dustpot/indoor-air-monitor/docs/images/asthma-index-bedroom.jpg

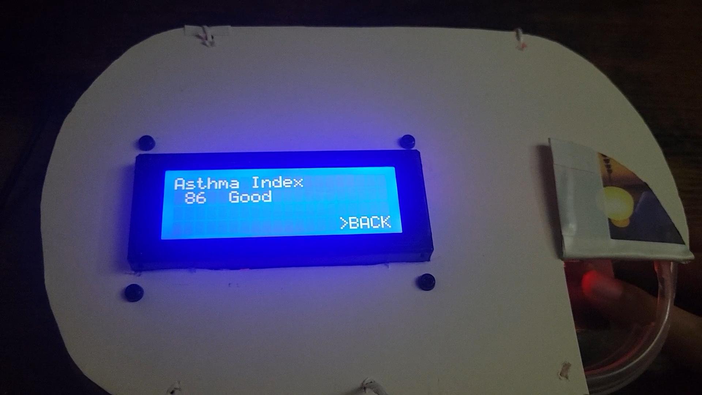
docs/images/asthma-index-bedroom.jpg
