dustpot/indoor-air-monitor/docs/images/asthma-index-kitchen.jpg

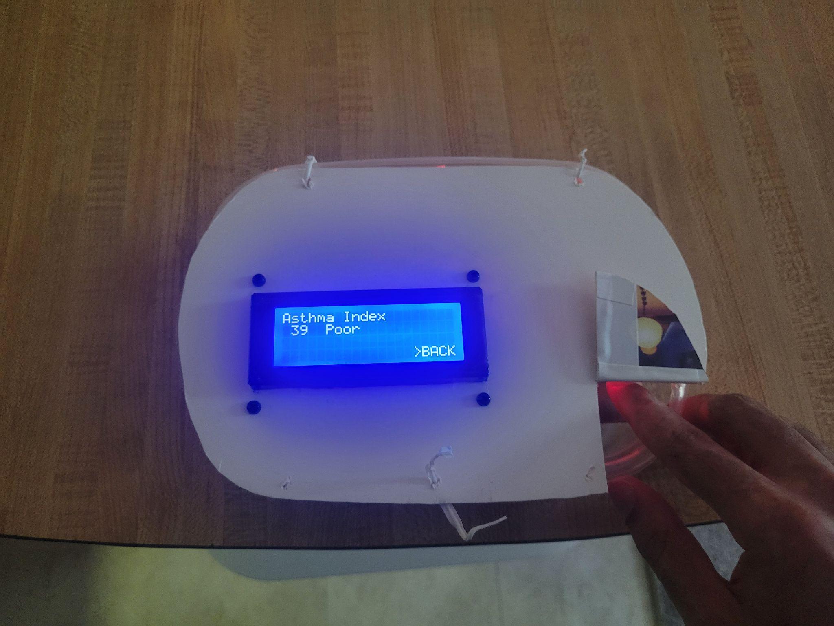
docs/images/asthma-index-kitchen.jpg
