dustpot/indoor-air-monitor/docs/images/breadboard-prototype.jpg

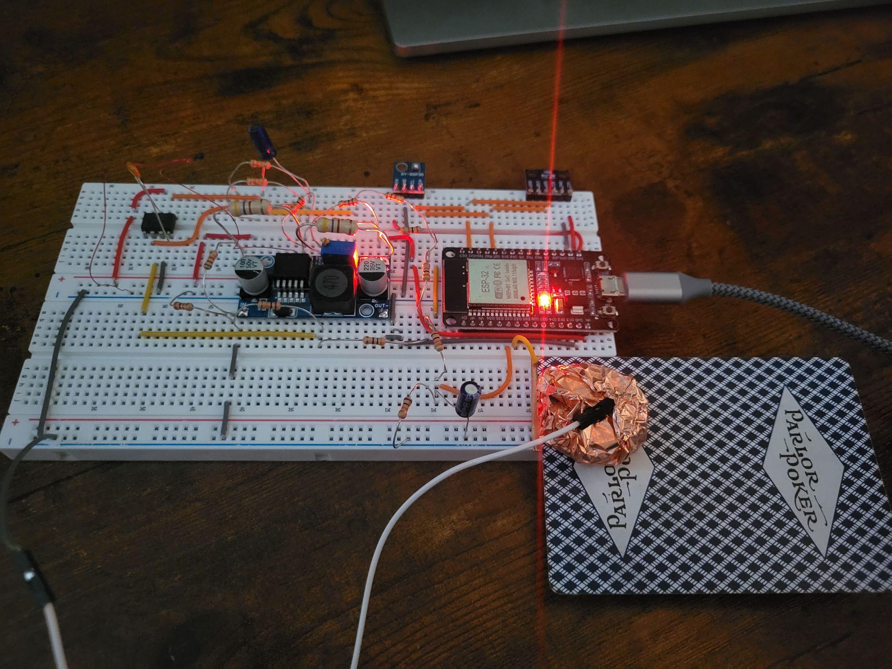
docs/images/breadboard-prototype.jpg
