dustpot/indoor-air-monitor/docs/BOM.md

# Bill of materials

From Appendix C of the final report ([report.pdf](report.pdf)).

| Part | Qty | Cost | Link | Notes |
| --- | --- | --- | --- | --- |
| ESP32 dev board (CP2102) | 1 | $9.39 | [link](https://www.amazon.com/dp/B07WCG1PLV) | μC, WiFi, touch peripheral, ADC |
| BME280 breakout | 1 | $8.99 | [link](https://www.amazon.com/dp/B01N47LZ4P) | Temp/%RH/Pressure, pre-packaged #1 |
| SGP30 breakout | 1 | $12.49 | [link](https://www.amazon.com/dp/B0CDWXNZR9) | eCO₂/TVOC, pre-packaged #2 |
| 10 kΩ NTC thermistor (10-pk) | 1 | $7.99 | [link](https://www.amazon.com/dp/B0F3X2G4D2) | RAW sensor; β fitted 3992 K |
| TL071CP op-amp | 1 | $0.51 | [link](https://www.digikey.com/en/products/detail/texas-instruments/TL071CP/378372) | Thermistor front-end gain stage |
| Resistors R₁–R₈ | 8 | $0.80 | [link](https://www.digikey.com/en/products/filter/through-hole-resistors/53) | Front-end network |
| Capacitors C₁–C₃ | 3 | $0.30 | [link](https://www.digikey.com/en/products/filter/aluminum-electrolytic-capacitors/58) | Filters and decoupling |
| LM2596 buck module (2-pk) | 1 | $4.99 | [link](https://www.amazon.com/dp/B0D7ZWVSFW) | Battery's ~8.4 V to a regulated 5.0 V |
| 6×AA NiMH + charger | 1 | $15.29 | [link](https://www.amazon.com/dp/B0GJCSSBFN) | ~20 Wh; more energy than 9 V alternative |
| Copper tape | 1 | $7.99 | [link](https://www.amazon.com/dp/B09Z6F9RFG) | Homemade capacitive sensor |
| 20×4 LCD w/ I²C backpack (2-pk) | 1 | $8.99 | [link](https://www.amazon.com/HiLetgo-Display-Backlight-Controller-Character/dp/B00HJ6AFW6) | Menu UI; 2pk is same price as single |
| Battery holder (6×AA) | 1 | $6.59 | [link](https://www.amazon.com/dp/B01N2INSBR) | 6 AA 9 V case with leads |
| Tupperware enclosure (3-pk) | 1 | $3.49 | [link](https://www.kroger.com/p/rubbermaid-takealongs-rectangle-food-storage-container-4-cup-tint-chili-3-count/0007169123100) | Link is close but not exact: 3pk from Kroger |

**Total ≈ $87.81**
