dustpot/indoor-air-monitor/data/Pressure Calibration (field 3).xlsx

created_at | entry_id | field3 | Average
2026-06-21 00:05:24 UTC | 1 | 987.54083 | 987.49112
2026-06-21 00:05:44 UTC | 2 | 987.52454
2026-06-21 00:06:05 UTC | 3 | 987.53131
2026-06-21 00:06:25 UTC | 4 | 987.51733
2026-06-21 00:06:46 UTC | 5 | 987.52032
2026-06-21 00:07:06 UTC | 6 | 987.52533
2026-06-21 00:07:27 UTC | 7 | 987.49237
2026-06-21 00:07:47 UTC | 8 | 987.50873
2026-06-21 00:08:08 UTC | 9 | 987.48883
2026-06-21 00:08:28 UTC | 10 | 987.47455
2026-06-21 00:08:49 UTC | 11 | 987.50415
2026-06-21 00:09:10 UTC | 12 | 987.46814
2026-06-21 00:09:30 UTC | 13 | 987.49292
2026-06-21 00:09:51 UTC | 14 | 987.47925
2026-06-21 00:10:11 UTC | 15 | 987.45709
2026-06-21 00:10:32 UTC | 16 | 987.47729
2026-06-21 00:10:52 UTC | 17 | 987.50281
2026-06-21 00:11:13 UTC | 18 | 987.47925
2026-06-21 00:11:33 UTC | 19 | 987.55627
2026-06-21 00:11:53 UTC | 20 | 987.52734
2026-06-21 00:12:14 UTC | 21 | 987.55737
2026-06-21 00:12:35 UTC | 22 | 987.52765
2026-06-21 00:12:55 UTC | 23 | 987.5578
2026-06-21 00:13:16 UTC | 24 | 987.58002
2026-06-21 00:13:36 UTC | 25 | 987.60541
2026-06-21 00:13:57 UTC | 26 | 987.57471
2026-06-21 00:14:17 UTC | 27 | 987.6167
2026-06-21 00:14:38 UTC | 28 | 987.6015
