dustpot/indoor-air-monitor/data/Temp Calibration (field 1).xlsx

created_at | entry_id | field1
2026-06-20 23:44:07 UTC | 1 | 23.95
2026-06-20 23:44:28 UTC | 2 | 18.19
2026-06-20 23:44:48 UTC | 3 | 12.99
2026-06-20 23:45:24 UTC | 4 | 7.74
2026-06-20 23:45:44 UTC | 5 | 5.82
2026-06-20 23:46:04 UTC | 6 | 4.66
2026-06-20 23:46:25 UTC | 7 | 3.5
2026-06-20 23:46:45 UTC | 8 | 2.65
2026-06-20 23:47:02 UTC | 9 | 2.22
2026-06-20 23:47:22 UTC | 10 | 1.81
2026-06-20 23:47:42 UTC | 11 | 1.49
2026-06-20 23:48:03 UTC | 12 | 1.27 | Average of final 10
2026-06-20 23:48:23 UTC | 13 | 1.1 | 1.201
2026-06-20 23:48:43 UTC | 14 | 1.11
2026-06-20 23:49:04 UTC | 15 | 1.05
2026-06-20 23:49:24 UTC | 16 | 0.99
2026-06-20 23:49:45 UTC | 17 | 0.99
2026-06-20 23:50:06 UTC | 18 | 1.37
2026-06-20 23:50:26 UTC | 19 | 1.39
2026-06-20 23:50:46 UTC | 20 | 1.38
2026-06-20 23:51:07 UTC | 21 | 1.36
2026-06-20 23:51:27 UTC | 22 | 1.27
