dustpot/indoor-air-monitor/hardware/kicad/Sensors_Course_Project.kicad_pcb

## KiCad design hardware/kicad/Sensors_Course_Project.kicad_pcb (2026-10-09)

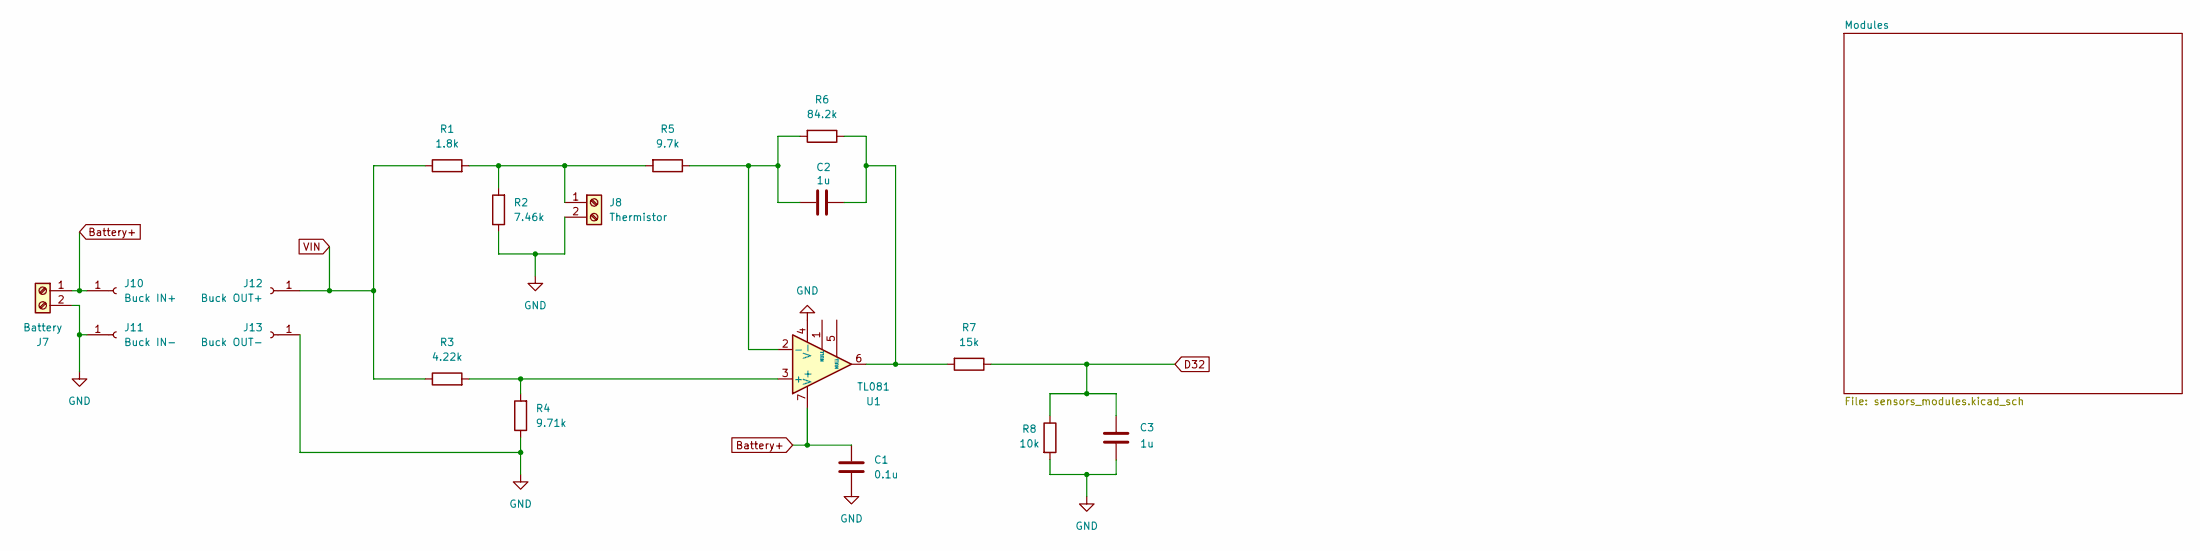
[picture p26: schematic Sensors_Course_Project.kicad_sch]

Parts:
C1: 0.1u; C_Disc_D5.0mm_W2.5mm_P2.50mm
C2, C3: 1u; CP_Radial_D5.0mm_P2.00mm
J7: Battery; TerminalBlock_Phoenix_MKDS-1,5-2-5.08_1x02_P5.08mm_Horizont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
J8: Thermistor; TerminalBlock_Phoenix_MKDS-1,5-2-5.08_1x02_P5.08mm_Horizont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
J10: Buck IN+; PinSocket_1x01_P2.54mm_Vertical
J11: Buck IN-; PinSocket_1x01_P2.54mm_Vertical
J12: Buck OUT+; PinSocket_1x01_P2.54mm_Vertical
J13: Buck OUT-; PinSocket_1x01_P2.54mm_Vertical
R1: 1.8k; R_Axial_DIN0207_L6.3mm_D2.5mm_P7.62mm_Horizontal
R2: 7.46k; R_Axial_DIN0207_L6.3mm_D2.5mm_P7.62mm_Horizontal
R3: 4.22k; R_Axial_DIN0207_L6.3mm_D2.5mm_P7.62mm_Horizontal
R4: 9.71k; R_Axial_DIN0207_L6.3mm_D2.5mm_P7.62mm_Horizontal
R5: 9.7k; R_Axial_DIN0207_L6.3mm_D2.5mm_P7.62mm_Horizontal
R6: 84.2k; R_Axial_DIN0207_L6.3mm_D2.5mm_P7.62mm_Horizontal
R7: 15k; R_Axial_DIN0207_L6.3mm_D2.5mm_P7.62mm_Horizontal
R8: 10k; R_Axial_DIN0207_L6.3mm_D2.5mm_P7.62mm_Horizontal
U1: TL081; DIP-8_W7.62mm

Connections:
Battery+: C1.1, J7.1, J10.1, U1.7 (V+)
D32: C3.2, R7.1, R8.1; also elsewhere on the board
GND: C1.2, C3.1, J7.2, J8.2, J11.1, J13.1, R2.1, R4.1, R8.2, U1.4 (V-); also elsewhere on the board
unnamed: C2.2, R6.1, R7.2, U1.6
unnamed: J8.1, R1.2, R2.2, R5.2
unnamed: R3.2, R4.2, U1.3 (+)
unnamed: C2.1, R5.1, R6.2, U1.2 (-)
VIN: J12.1, R1.1, R3.1; also elsewhere on the board

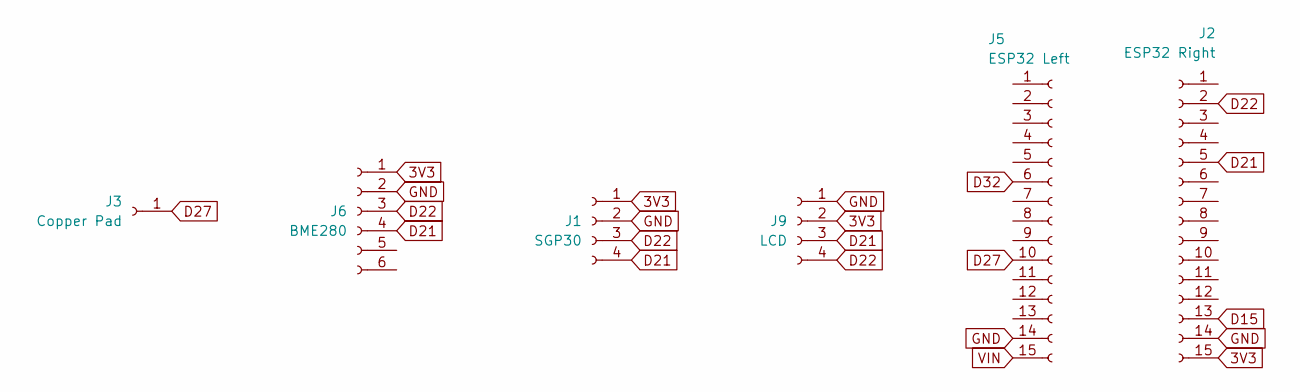
[picture p27: schematic sensors_modules.kicad_sch]

Parts:
J1: SGP30; PinSocket_1x04_P2.54mm_Vertical
J2: ESP32 Right; PinSocket_1x15_P2.54mm_Vertical
J3: Copper Pad; JST_XH_B1B-XH-AM_1x01_P2.50mm_Vertical
J5: ESP32 Left; PinSocket_1x15_P2.54mm_Vertical
J6: BME280; PinSocket_1x06_P2.54mm_Vertical
J9: LCD; PinSocket_1x04_P2.54mm_Vertical

Connections:
3V3: J1.1, J2.15, J6.1, J9.2
D15: J2.13
D21: J1.4, J2.5, J6.4, J9.3
D22: J1.3, J2.2, J6.3, J9.4
D27: J3.1, J5.10
D32: J5.6; also elsewhere on the board
GND: J1.2, J2.14, J5.14, J6.2, J9.1; also elsewhere on the board
VIN: J5.15; also elsewhere on the board

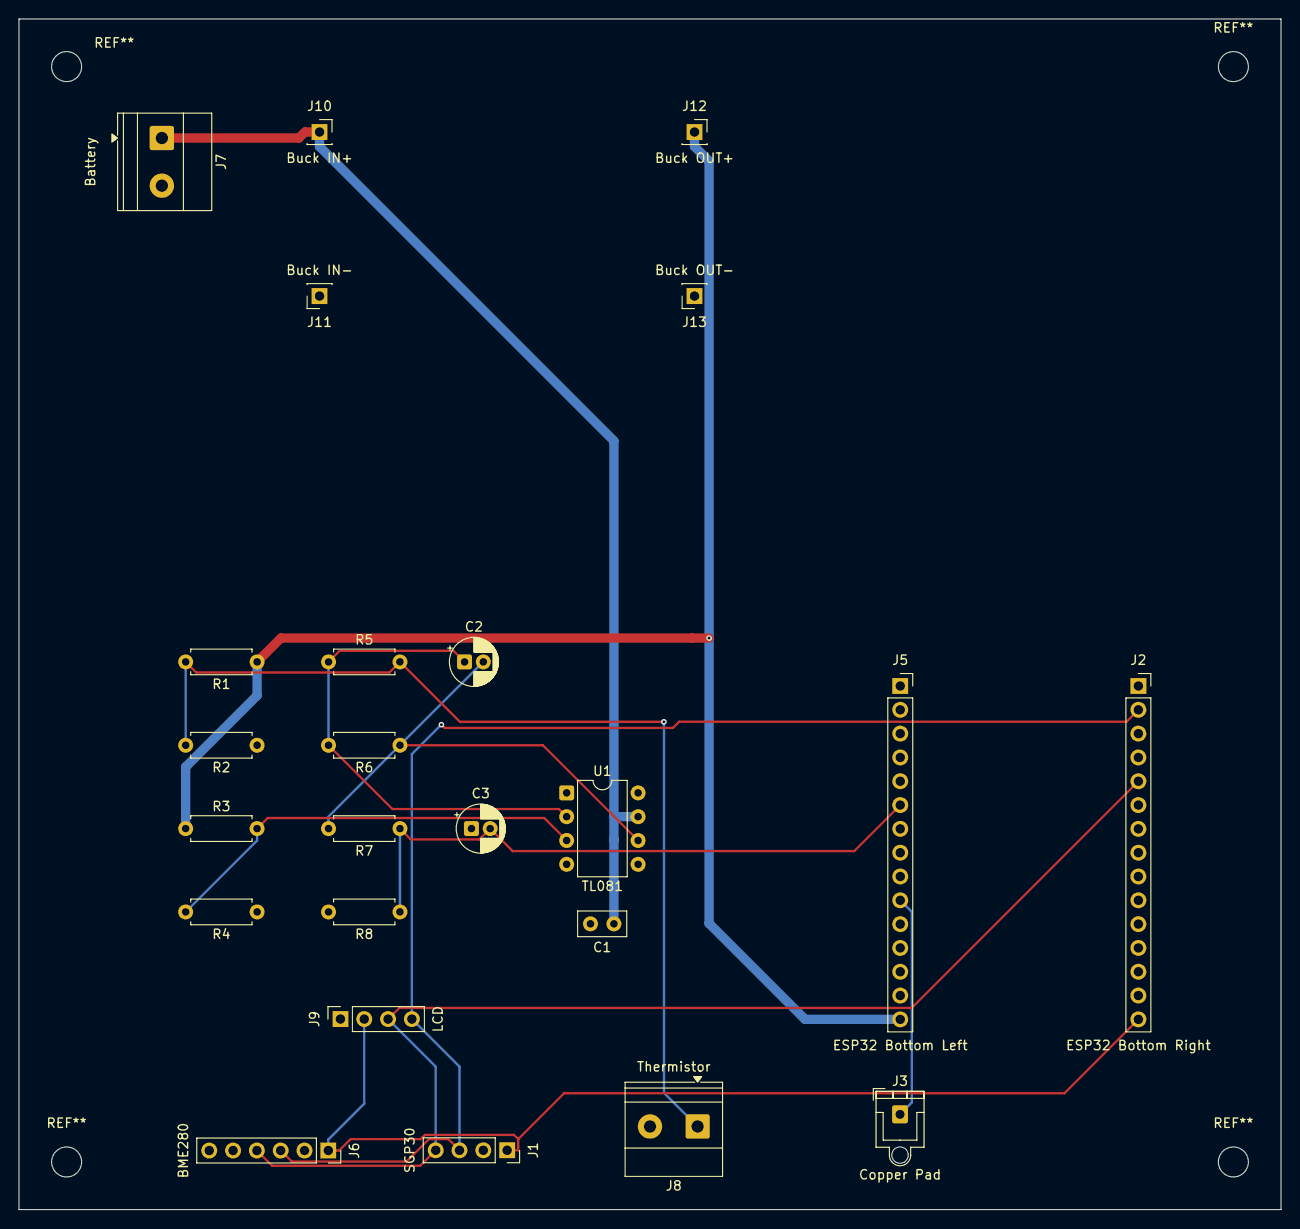
[picture p28: board Sensors_Course_Project.kicad_pcb from above]

Board: 2 copper layers, 134.6 x 127.0 mm, 24 parts (0 on the bottom side), 12 nets.
